plai3r1undo/plantMonitor/hardware/pcb/render/bottom.png

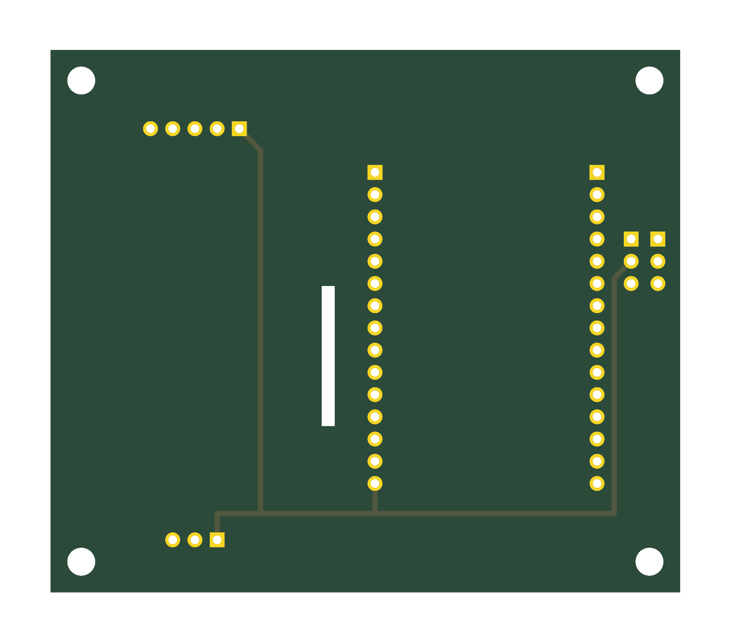
hardware/pcb/render/bottom.png
