plai3r1undo/plantMonitor/hardware/pcb/print-test-1to1.pdf

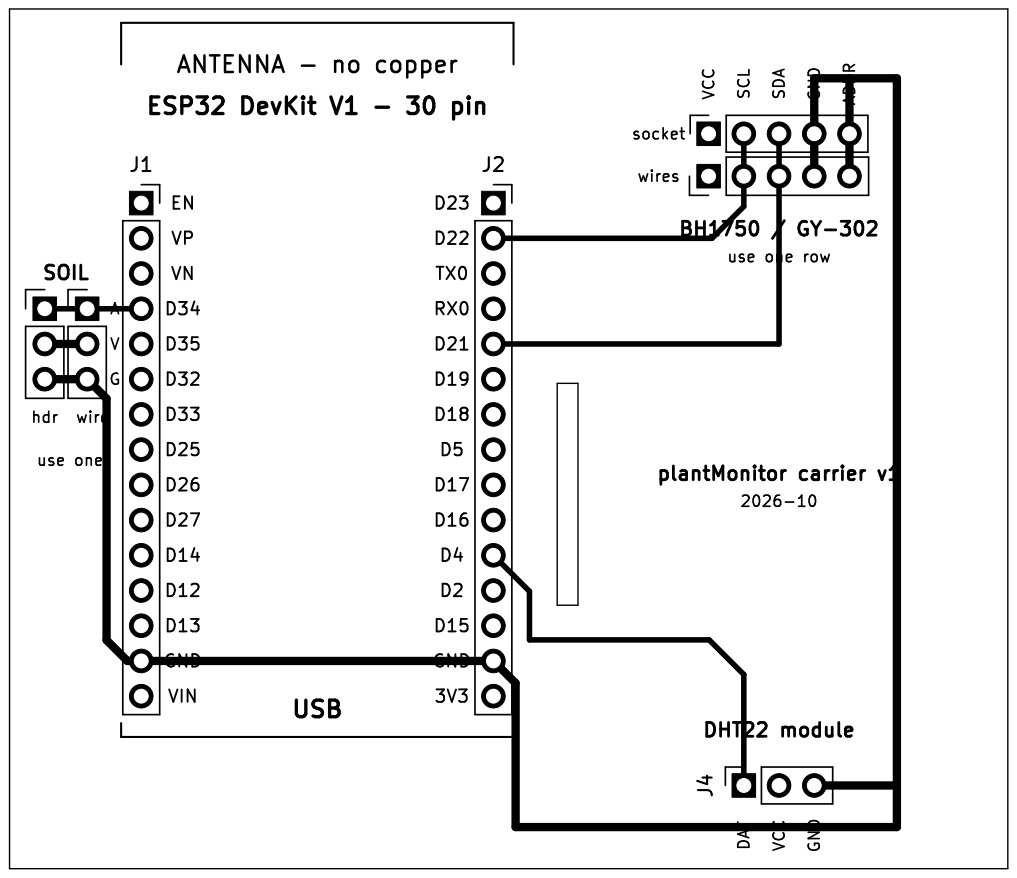
[picture p3: page 1]

Id: 1/1 Title: File: plant-carrier.kicad_pcb Sheet:
