plai3r1undo/plantMonitor/hardware/pcb/plant-carrier.kicad_pcb

## KiCad design hardware/pcb/plant-carrier.kicad_pcb (2026-11-03)

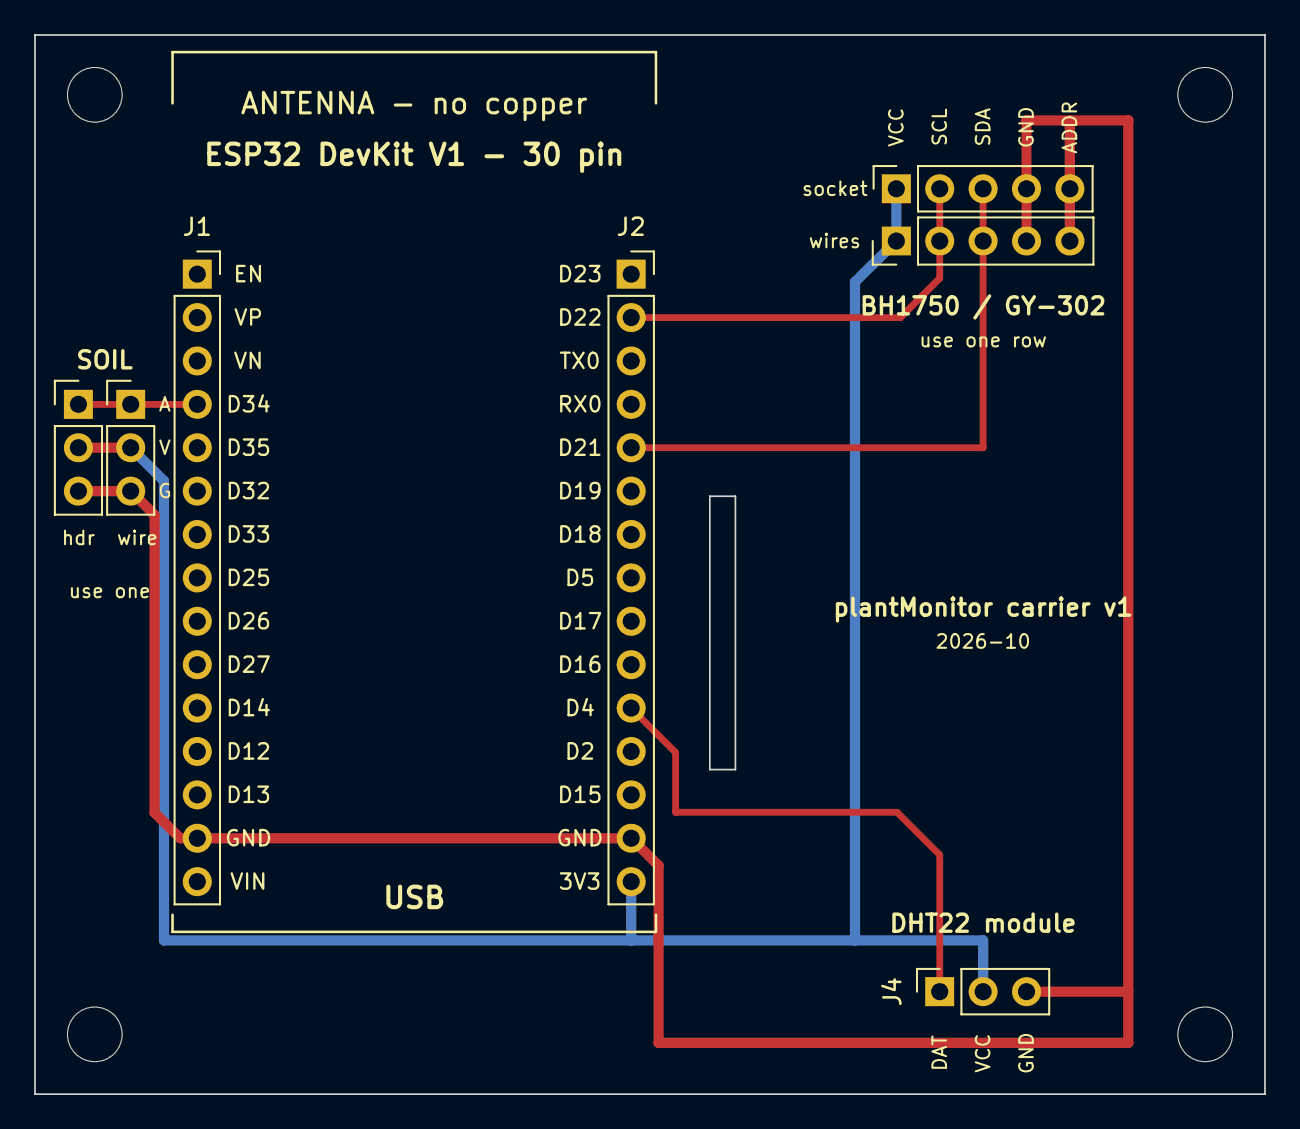
[picture p4: board plant-carrier.kicad_pcb from above]

Board: 2 copper layers, 72.0 x 62.0 mm, 11 parts (0 on the bottom side), 6 nets.

Parts:
H1, H2, H3, H4: M3; MountingHole_3.2mm_M3
J1: ESP32 left; PinSocket_1x15_P2.54mm_Vertical
J2: ESP32 right; PinSocket_1x15_P2.54mm_Vertical
J3: BH1750 (GY-302); PinSocket_1x05_P2.54mm_Vertical
J4: DHT22 module; PinSocket_1x03_P2.54mm_Vertical
J5: Soil header; PinHeader_1x03_P2.54mm_Vertical
J6: Soil solder holes; PinHeader_1x03_P2.54mm_Vertical
J7: BH1750 solder holes; PinHeader_1x05_P2.54mm_Vertical

Connections:
+3V3: J2.15, J3.1, J4.2, J5.2, J6.2, J7.1
DHT_DATA: J2.11, J4.1
GND: J1.14, J2.14, J3.4, J3.5, J4.3, J5.3, J6.3, J7.4, J7.5
SCL: J2.2, J3.2, J7.2
SDA: J2.5, J3.3, J7.3
SOIL: J1.4, J5.1, J6.1
