plai3r1undo/plantMonitor/(commit log)

2026-10-14 Add plant monitor: ESP32 firmware, Rust server, web UI, deployment
    - firmware/: ESP32 sensor node (Arduino/PlatformIO) reading BH1750, DHT22
    and HW-390, posting over HTTPS with a pinned root CA, deep sleep between
    readings
    - server/: Rust (axum) server with SQLite storage, species-based plant
    evaluation, web UI for plants/species, login with Argon2id and rate
    limiting, read-only API tokens, CSV/JSON export and ntfy alerts;
    sensor readings accepted only from LAN addresses
    - deploy/: hardened systemd unit, Caddy config (LAN site with internal CA,
    optional public site), install script
    - build.sh: firmware setup/build/flash/monitor and server build/run/test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
2026-10-21 added hardware for the sensors
2026-11-03 Let plants switch off individual sensors
    Soil, light and temperature/humidity can be turned off per plant, e.g.
    when the soil probe of a dormant cactus is unplugged. A sensor that is
    off isn't checked or alerted on, its values aren't stored (an unplugged
    probe reads noise), and the soil drying check pauses. Open alerts are
    dropped without a recovery message. Calibration still sees raw values.
2026-11-03 Add sensor carrier PCB
    A 72 x 62 mm two-layer board for the ESP32 DevKit (30 pin) with sockets
    for the DHT22 and BH1750 and a header for the soil sensor, plus solder
    holes for wiring the light and soil sensors directly. Generated by
    generate_pcb.py (KiCad 9); includes gerbers, renders and a 1:1 print test.
